jaemin0319/HYPER/mujoco/images/standing_front.png

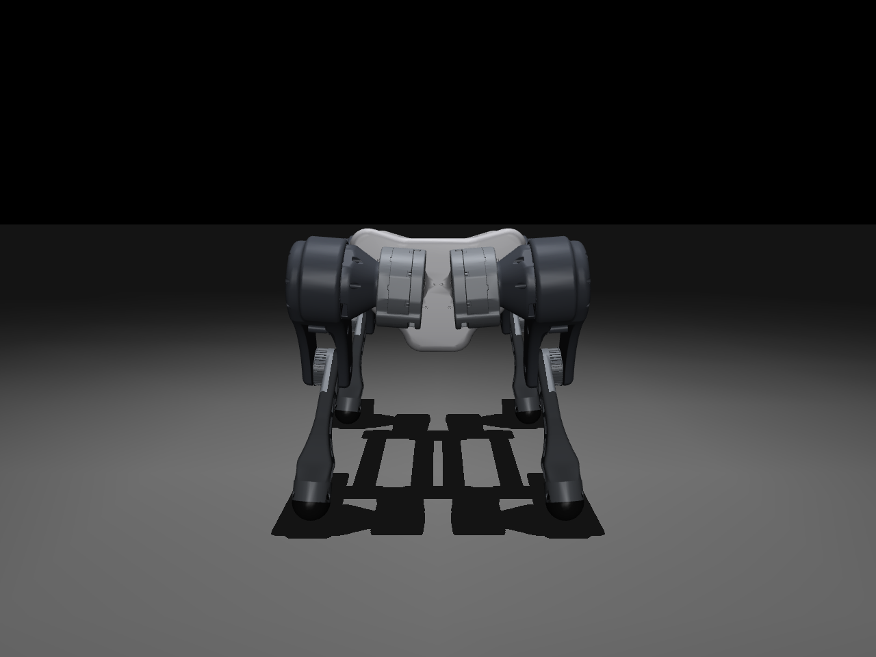
mujoco/images/standing_front.png
