jaemin0319/HYPER/mujoco/images/standing_side.png

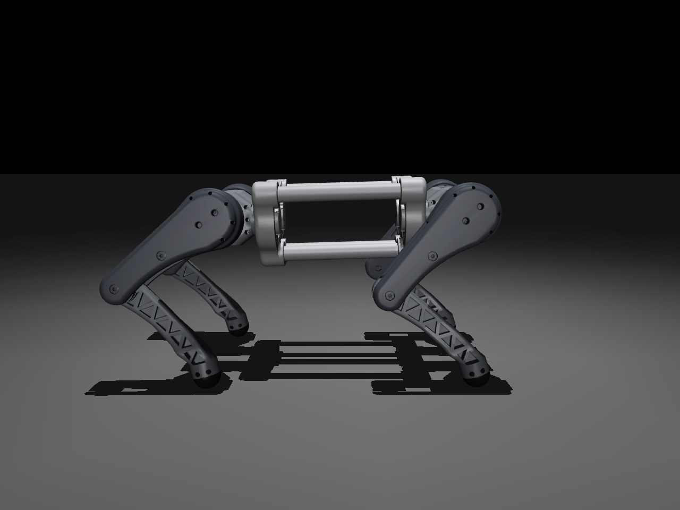
mujoco/images/standing_side.png
