jaemin0319/HYPER/mujoco/images/standing_top.png

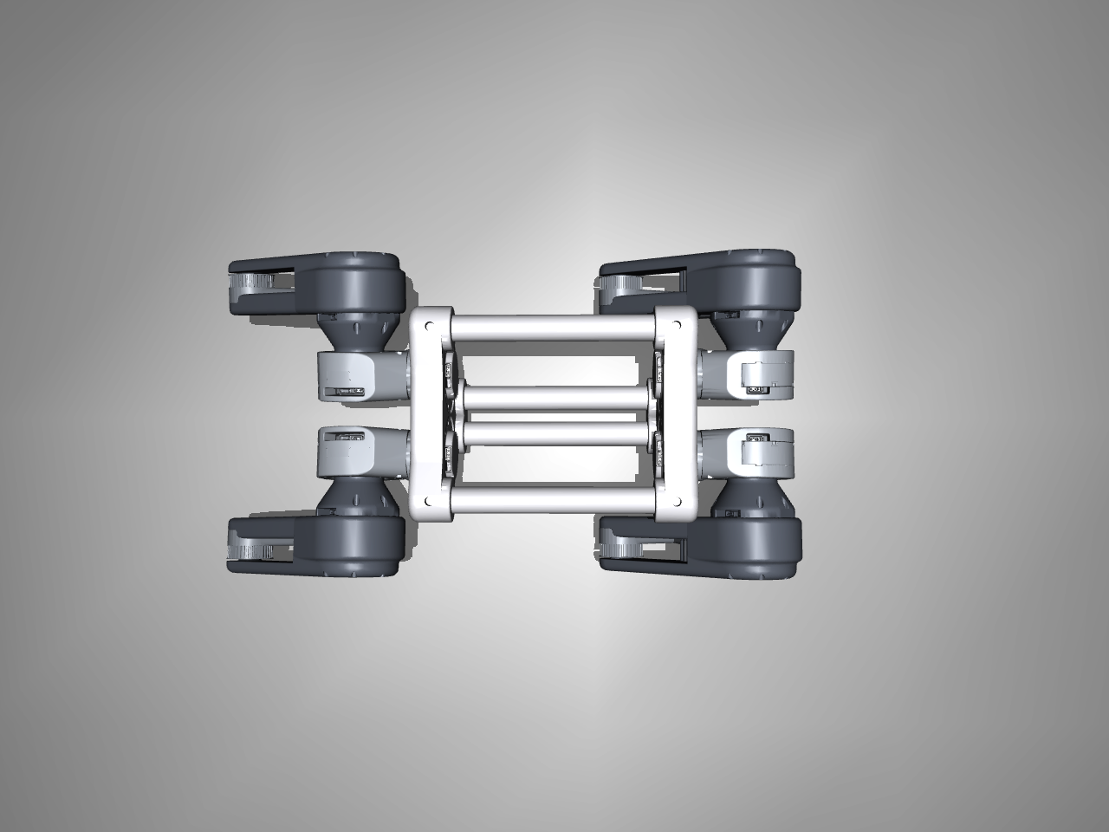
mujoco/images/standing_top.png
