jaemin0319/HYPER/meshes/calf_foot_mirror.stl

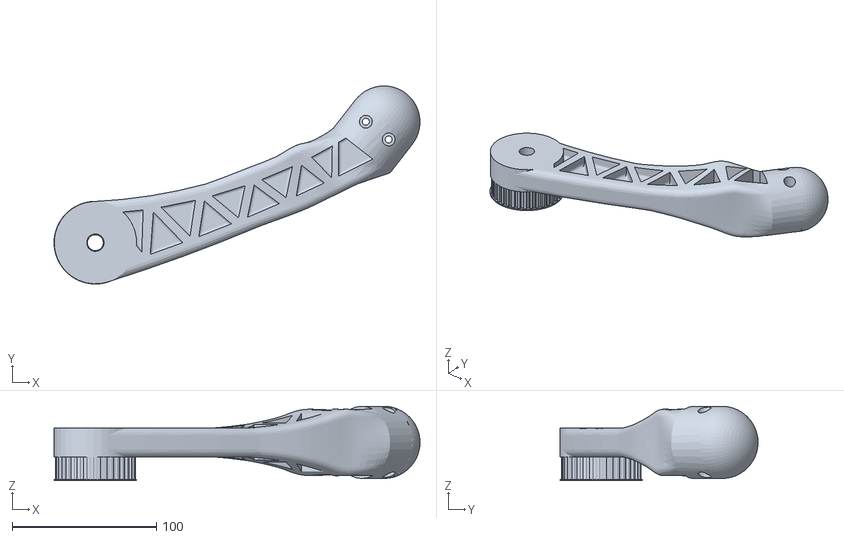
[picture p6: CAD file, 2026-11-10]
meshes/calf_foot_mirror.stl
253.3 x 137.1 x 51.5
