jaemin0319/HYPER/meshes/collision/trunk_c09.stl

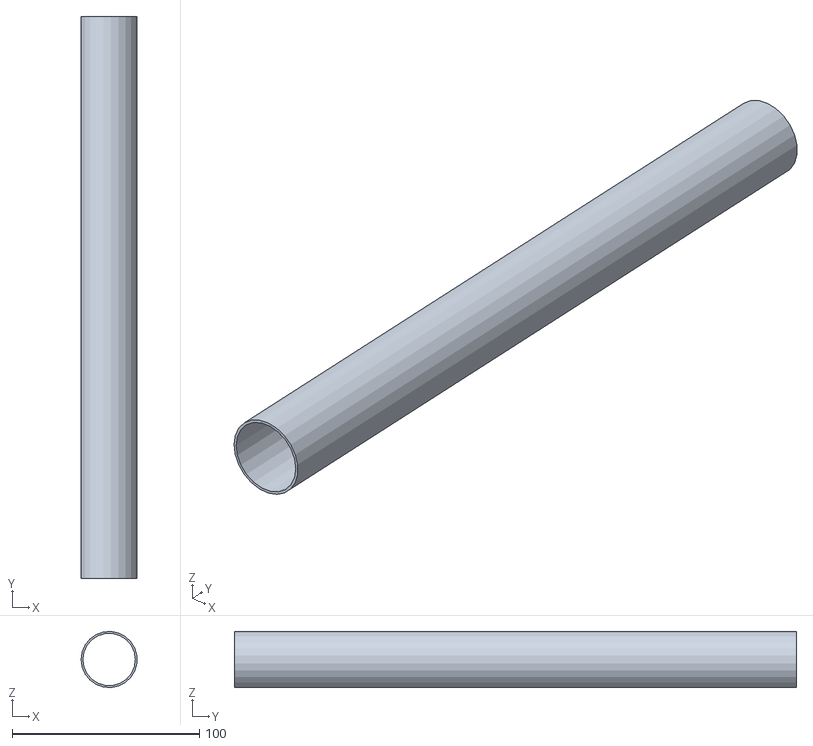
[picture p7: CAD file, 2026-11-10]
meshes/collision/trunk_c09.stl
29.9 x 300.0 x 29.9
