jaemin0319/HYPER/meshes/collision/thigh_c05.stl

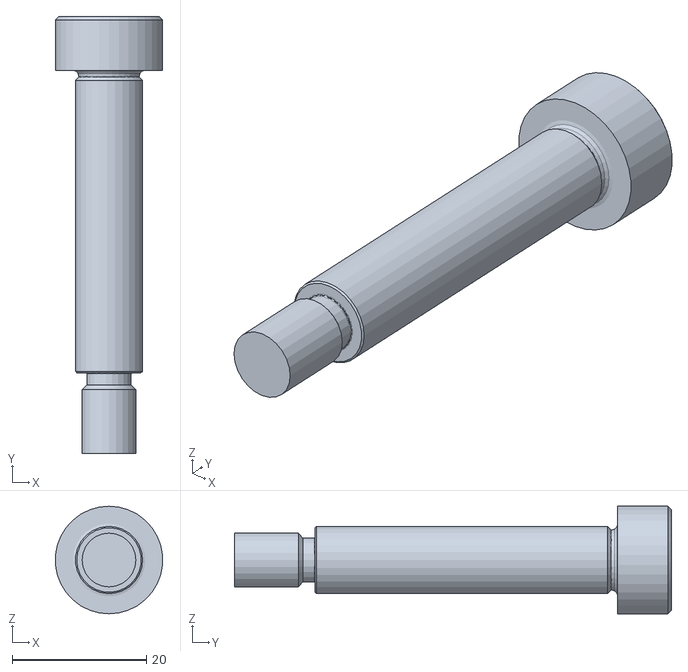
[picture p8: CAD file, 2026-11-10]
meshes/collision/thigh_c05.stl
15.9 x 65.0 x 16.0
