jaemin0319/HYPER/meshes/collision/thigh_c01.stl

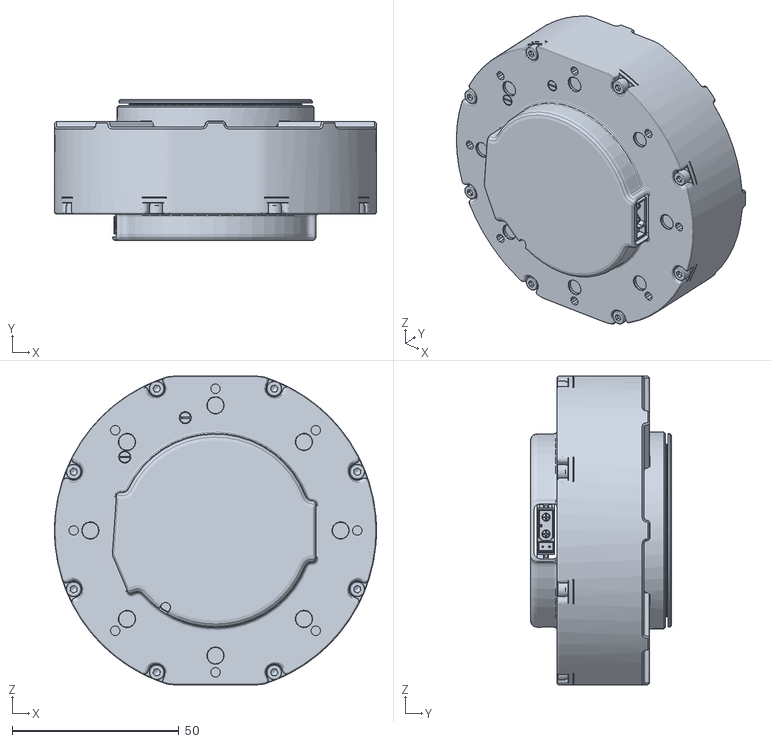
[picture p9: CAD file, 2026-11-10]
meshes/collision/thigh_c01.stl
96.5 x 42.3 x 92.5
