jaemin0319/HYPER/meshes/trunk.stl

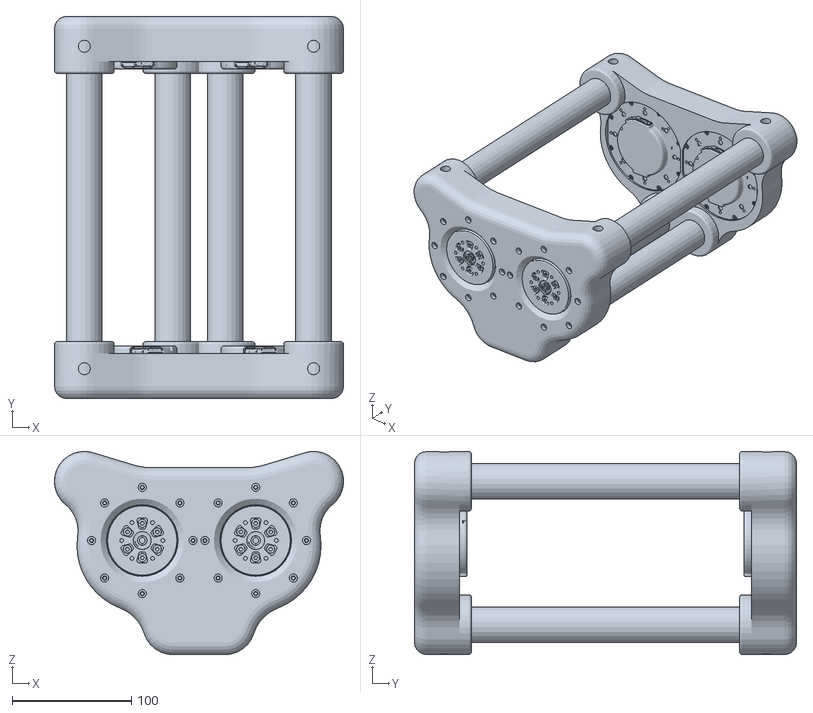
[picture p10: CAD file, 2026-11-10]
meshes/trunk.stl
242.0 x 320.0 x 170.0
