jaemin0319/HYPER/meshes/hip.stl

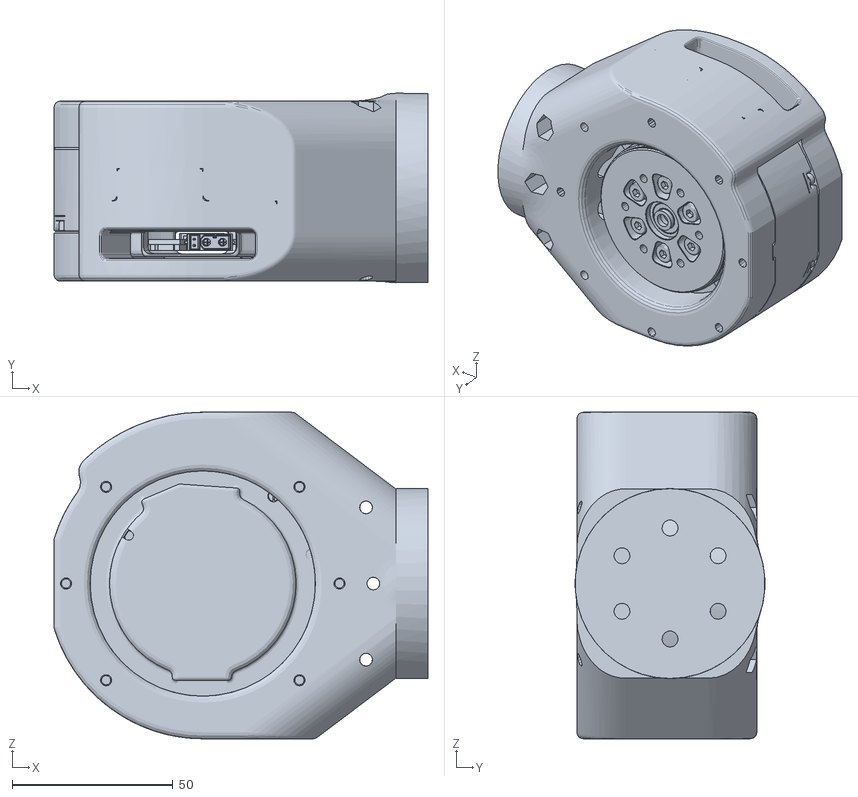
[picture p11: CAD file, 2026-11-10]
meshes/hip.stl
116.3 x 58.9 x 101.5
