jaemin0319/HYPER/meshes/collision/hip_c02_mirror.stl

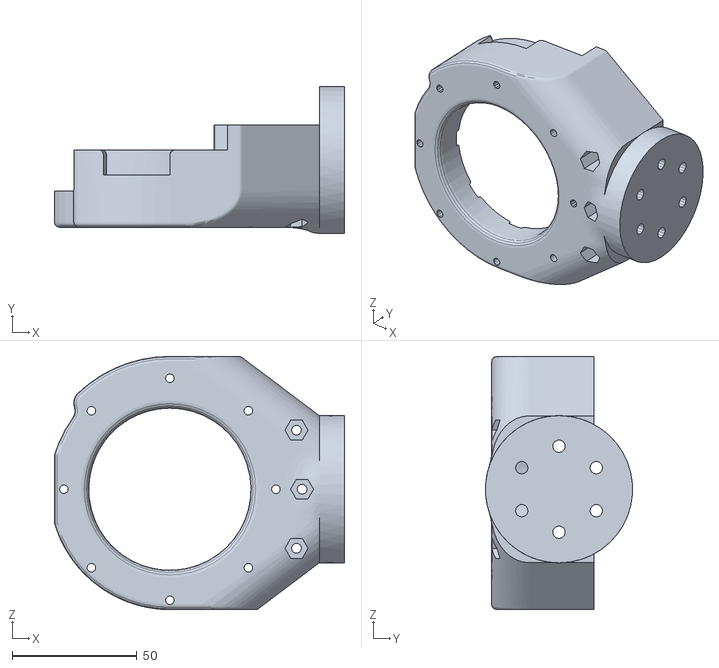
[picture p12: CAD file, 2026-11-10]
meshes/collision/hip_c02_mirror.stl
116.2 x 58.9 x 101.5
