jaemin0319/HYPER/meshes/thigh_mirror.stl

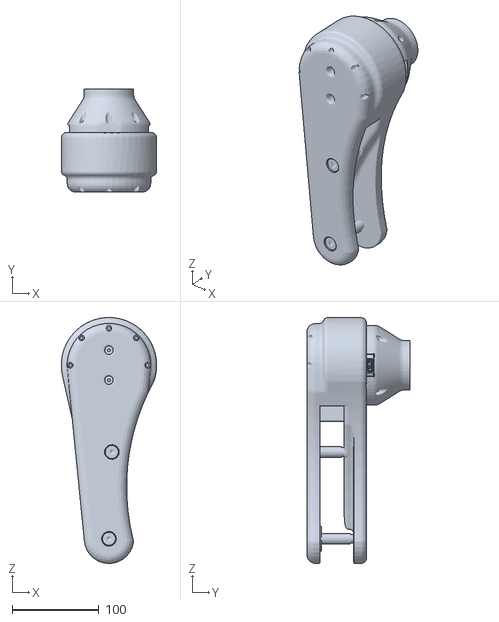
[picture p13: CAD file, 2026-11-10]
meshes/thigh_mirror.stl
109.8 x 119.0 x 283.5
