jaemin0319/HYPER/meshes/collision/thigh_c03_mirror.stl

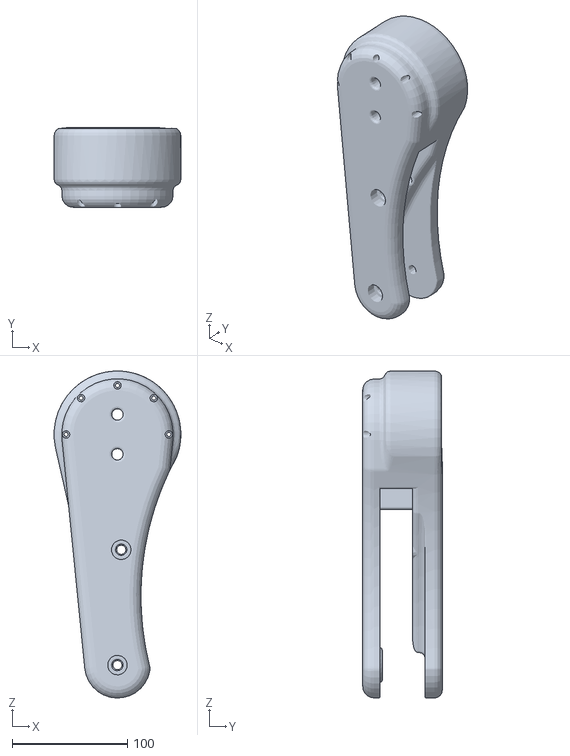
[picture p14: CAD file, 2026-11-10]
meshes/collision/thigh_c03_mirror.stl
109.8 x 69.0 x 283.5
