jaemin0319/HYPER/meshes/collision/trunk_c06.stl

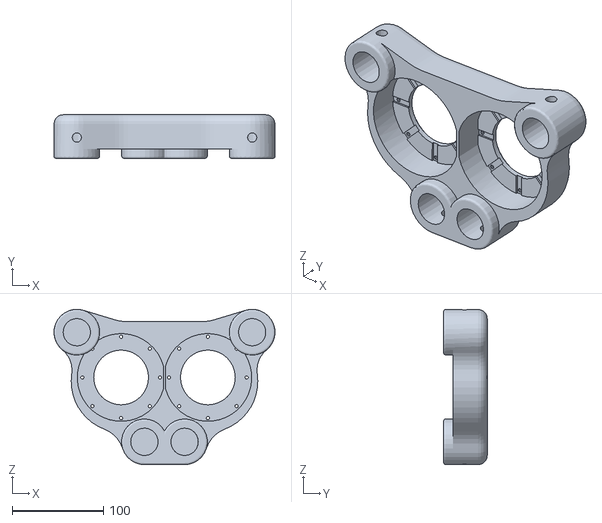
[picture p15: CAD file, 2026-11-10]
meshes/collision/trunk_c06.stl
242.0 x 47.7 x 170.0
