jaemin0319/HYPER/meshes/collision/hip_c03_mirror.stl

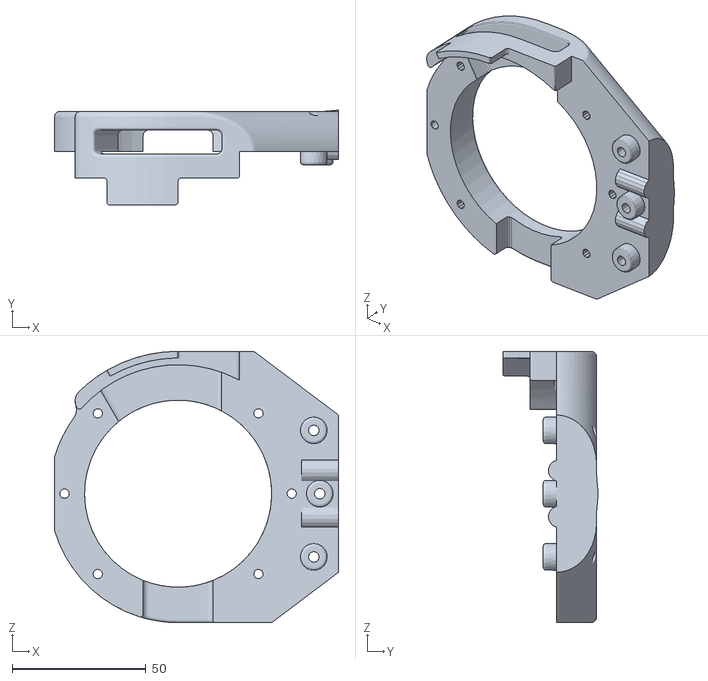
[picture p16: CAD file, 2026-11-10]
meshes/collision/hip_c03_mirror.stl
106.2 x 35.5 x 101.5
