jaemin0319/HYPER/meshes/collision/thigh_c07.stl

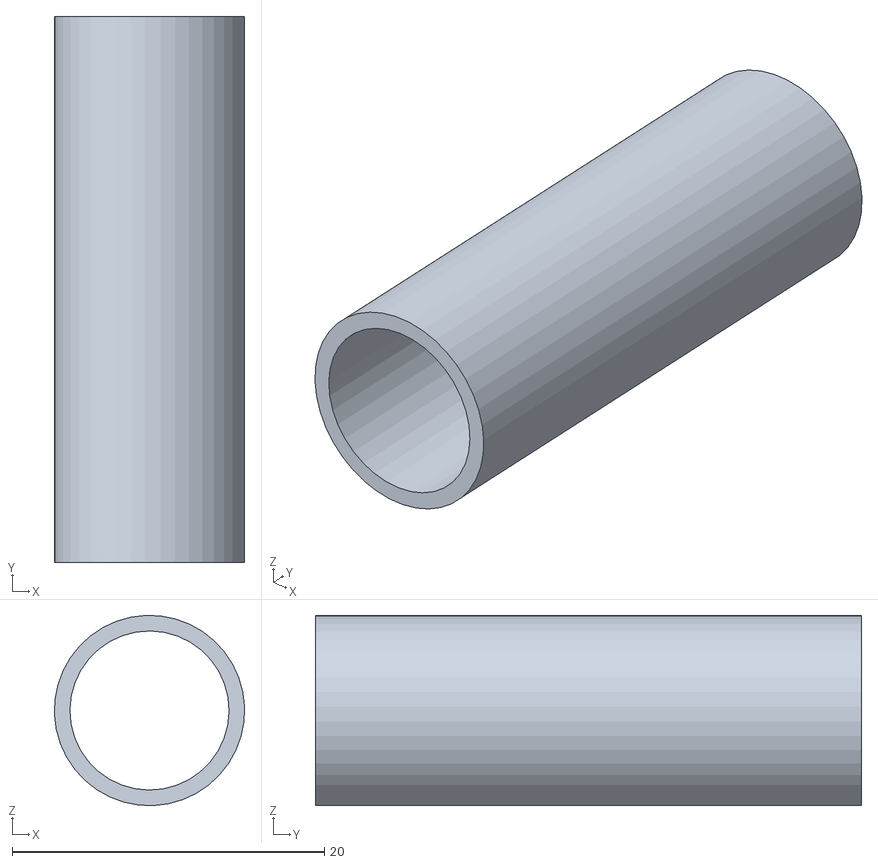
[picture p17: CAD file, 2026-11-10]
meshes/collision/thigh_c07.stl
12.2 x 35.0 x 12.2
