jaemin0319/HYPER/meshes/collision/calf_foot_c03_mirror.stl

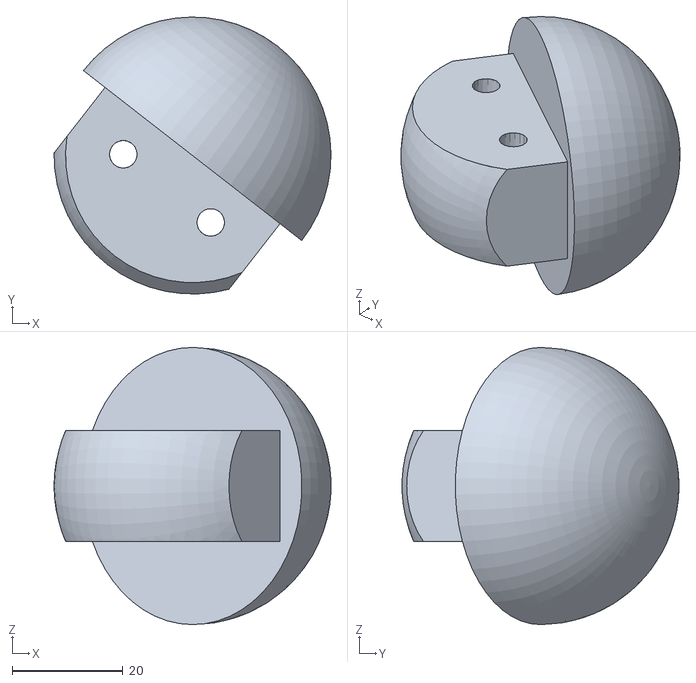
[picture p18: CAD file, 2026-11-10]
meshes/collision/calf_foot_c03_mirror.stl
50.0 x 49.9 x 50.0
