jaemin0319/HYPER/meshes/collision/calf_foot_c02_mirror.stl

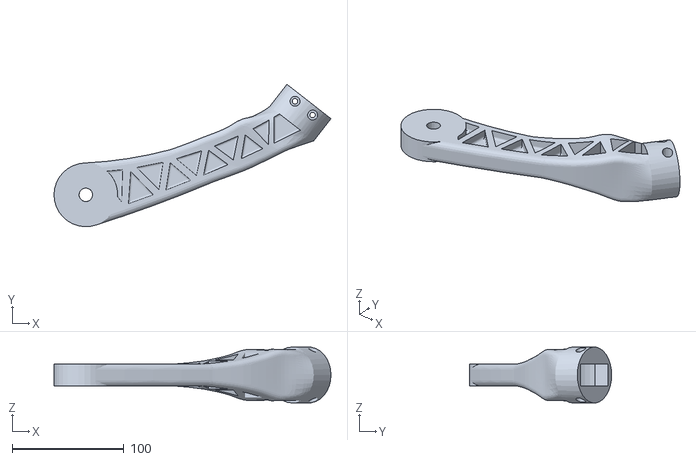
[picture p19: CAD file, 2026-11-10]
meshes/collision/calf_foot_c02_mirror.stl
247.9 x 127.4 x 50.0
