jaemin0319/HYPER/meshes/collision/calf_foot_c01.stl

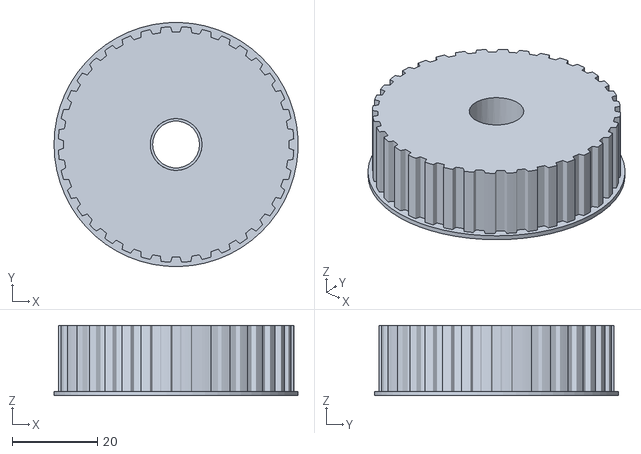
[picture p20: CAD file, 2026-11-10]
meshes/collision/calf_foot_c01.stl
57.3 x 57.3 x 16.5
