jaemin0319/HYPER/meshes/collision/thigh_c02_mirror.stl

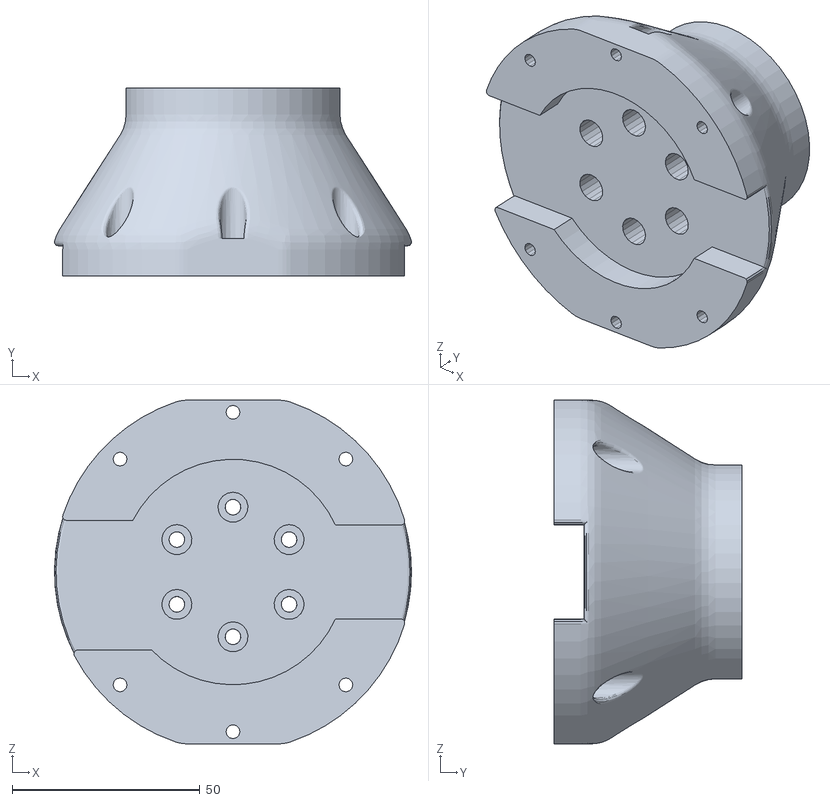
[picture p21: CAD file, 2026-11-10]
meshes/collision/thigh_c02_mirror.stl
95.0 x 50.0 x 91.5
