jaemin0319/HYPER/meshes/collision/thigh_c06_mirror.stl

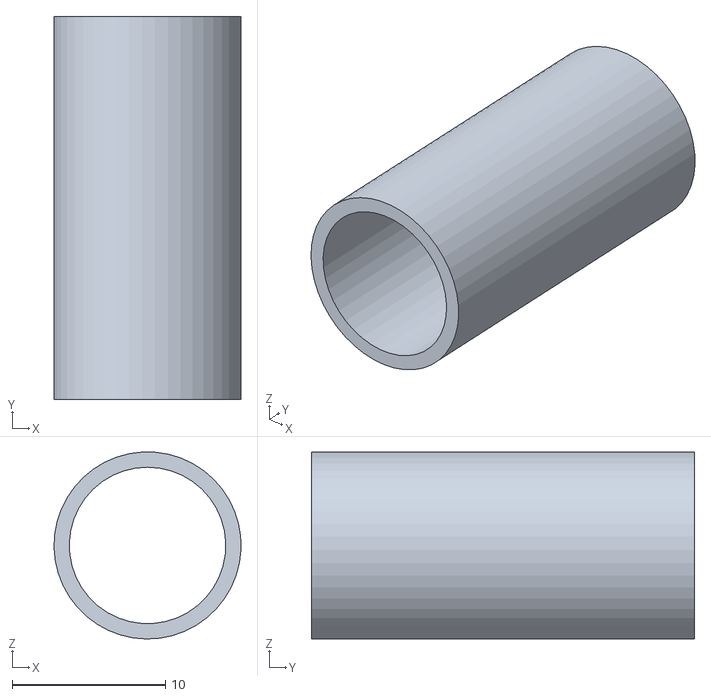
[picture p22: CAD file, 2026-11-10]
meshes/collision/thigh_c06_mirror.stl
12.2 x 25.0 x 12.2
