jaemin0319/HYPER/(list of files, cad)

Other CAD files:
meshes/calf_foot.stl
meshes/collision/trunk_c01.stl
meshes/hip_mirror.stl
meshes/collision/trunk_c08.stl
meshes/collision/thigh_c04_mirror.stl
meshes/thigh.stl
meshes/collision/thigh_c07_mirror.stl
meshes/collision/hip_c03.stl
meshes/collision/trunk_c02.stl
meshes/collision/trunk_c05.stl
meshes/collision/calf_foot_c03.stl
meshes/collision/trunk_c03.stl
meshes/collision/trunk_c07.stl
meshes/collision/thigh_c06.stl
meshes/collision/thigh_c03.stl
meshes/collision/hip_c01.stl
meshes/collision/calf_foot_c02.stl
meshes/collision/hip_c02.stl
meshes/collision/thigh_c04.stl
meshes/collision/thigh_c05_mirror.stl
meshes/collision/trunk_c10.stl
meshes/collision/thigh_c01_mirror.stl
meshes/collision/thigh_c02.stl
meshes/collision/calf_foot_c01_mirror.stl
meshes/collision/hip_c01_mirror.stl
meshes/collision/trunk_c04.stl
