jaemin0319/HYPER/urdf/hyper.urdf

<?xml version="1.0" encoding="utf-8"?>
<!-- hyper_v1 generated by inventor_automation/src/robot_export.py, run 20261110_132904. -->
<!-- Mass, centre of mass, inertia and joint positions: CAD trunk-hip-thigh-calf-foot.iam (Inventor). -->
<!-- Frame convention, joint names and position limits: Unitree Go2, -->
<!--   https://huggingface.co/datasets/unitreerobotics/unitree_model Go2/usd/configuration/go2_description_physics.usd, -->
<!--   as spawned by https://github.com/unitreerobotics/unitree_rl_lab @ 4960b84. -->
<!-- Effort and velocity: Unitree GO-M8010-6 at the output (23.7 N*m, 30 rad/s, gear 6.33) on every joint;
     the calf joint is belt driven 1:1 by a GO-M8010-6 mounted on the thigh. -->
<!-- Right legs mirror the left legs of the CAD about the base x-z plane. -->
<!-- CAD documents with unsaved changes at export (values are their in-memory state): thigh.iam, 숄더M8-L45.ipt -->
<robot name="hyper_v1">
  <!-- Read only by MuJoCo: keep mesh paths relative to this file, collide with the per-part meshes,
       keep the foot links (as Go2's dont_collapse). -->
  <mujoco>
    <compiler strippath="false" discardvisual="true" fusestatic="false"/>
  </mujoco>
  <material name="body"><color rgba="0.75 0.75 0.78 1"/></material>
  <material name="leg"><color rgba="0.25 0.25 0.28 1"/></material>
  <material name="foot"><color rgba="0.1 0.1 0.1 1"/></material>
  <link name="base">
    <inertial>
      <origin xyz="0 0 -0.000639621043705" rpy="0 0 0"/>
      <mass value="2.3042699539"/>
      <inertia ixx="0.00858349317117" ixy="-2.5093192408e-05" ixz="0" iyy="0.0451878348476" iyz="0" izz="0.0501336624466"/>
    </inertial>
    <visual>
      <origin xyz="-0.1260851649 0.0226682414116 -0.0104685283639" rpy="0 0 1.57079632679"/>
      <geometry><mesh filename="../meshes/trunk.stl" scale="0.001 0.001 0.001"/></geometry>
      <material name="body"/>
    </visual>
    <collision name="base_trunk_c01">
      <origin xyz="-0.1260851649 0.0226682414116 -0.0104685283639" rpy="0 0 1.57079632679"/>
      <geometry><mesh filename="../meshes/collision/trunk_c01.stl" scale="0.001 0.001 0.001"/></geometry>
    </collision>
    <collision name="base_trunk_c02">
      <origin xyz="-0.1260851649 0.0226682414116 -0.0104685283639" rpy="0 0 1.57079632679"/>
      <geometry><mesh filename="../meshes/collision/trunk_c02.stl" scale="0.001 0.001 0.001"/></geometry>
    </collision>
    <collision name="base_trunk_c03">
      <origin xyz="-0.1260851649 0.0226682414116 -0.0104685283639" rpy="0 0 1.57079632679"/>
      <geometry><mesh filename="../meshes/collision/trunk_c03.stl" scale="0.001 0.001 0.001"/></geometry>
    </collision>
    <collision name="base_trunk_c04">
      <origin xyz="-0.1260851649 0.0226682414116 -0.0104685283639" rpy="0 0 1.57079632679"/>
      <geometry><mesh filename="../meshes/collision/trunk_c04.stl" scale="0.001 0.001 0.001"/></geometry>
    </collision>
    <collision name="base_trunk_c05">
      <origin xyz="-0.1260851649 0.0226682414116 -0.0104685283639" rpy="0 0 1.57079632679"/>
      <geometry><mesh filename="../meshes/collision/trunk_c05.stl" scale="0.001 0.001 0.001"/></geometry>
    </collision>
    <collision name="base_trunk_c06">
      <origin xyz="-0.1260851649 0.0226682414116 -0.0104685283639" rpy="0 0 1.57079632679"/>
      <geometry><mesh filename="../meshes/collision/trunk_c06.stl" scale="0.001 0.001 0.001"/></geometry>
    </collision>
    <collision name="base_trunk_c07">
      <origin xyz="-0.1260851649 0.0226682414116 -0.0104685283639" rpy="0 0 1.57079632679"/>
      <geometry><mesh filename="../meshes/collision/trunk_c07.stl" scale="0.001 0.001 0.001"/></geometry>
    </collision>
    <collision name="base_trunk_c08">
      <origin xyz="-0.1260851649 0.0226682414116 -0.0104685283639" rpy="0 0 1.57079632679"/>
      <geometry><mesh filename="../meshes/collision/trunk_c08.stl" scale="0.001 0.001 0.001"/></geometry>
    </collision>
    <collision name="base_trunk_c09">
      <origin xyz="-0.1260851649 0.0226682414116 -0.0104685283639" rpy="0 0 1.57079632679"/>
      <geometry><mesh filename="../meshes/collision/trunk_c09.stl" scale="0.001 0.001 0.001"/></geometry>
    </collision>
    <collision name="base_trunk_c10">
      <origin xyz="-0.1260851649 0.0226682414116 -0.0104685283639" rpy="0 0 1.57079632679"/>
      <geometry><mesh filename="../meshes/collision/trunk_c10.stl" scale="0.001 0.001 0.001"/></geometry>
    </collision>
  </link>
  <link name="FL_hip">
    <inertial>
      <origin xyz="-0.00480355465229 0.0010624534626 -0.00071733906153" rpy="0 0 0"/>
      <mass value="0.6709044"/>
      <inertia ixx="0.000515811439886" ixy="-8.15128409291e-06" ixz="4.72324019516e-06" iyy="0.000935208201885" iyz="1.29329169829e-06" izz="0.000599549223576"/>
    </inertial>
    <visual>
      <origin xyz="-0.00356927369941 -0.00835504911739 -0.0025" rpy="3.14159265359 0 -3.14159265359"/>
      <geometry><mesh filename="../meshes/hip.stl" scale="0.001 0.001 0.001"/></geometry>
      <material name="leg"/>
    </visual>
    <collision name="FL_hip_hip_c01">
      <origin xyz="-0.00356927369941 -0.00835504911739 -0.0025" rpy="3.14159265359 0 -3.14159265359"/>
      <geometry><mesh filename="../meshes/collision/hip_c01.stl" scale="0.001 0.001 0.001"/></geometry>
    </collision>
    <collision name="FL_hip_hip_c02">
      <origin xyz="-0.00356927369941 -0.00835504911739 -0.0025" rpy="3.14159265359 0 -3.14159265359"/>
      <geometry><mesh filename="../meshes/collision/hip_c02.stl" scale="0.001 0.001 0.001"/></geometry>
    </collision>
    <collision name="FL_hip_hip_c03">
      <origin xyz="-0.00356927369941 -0.00835504911739 -0.0025" rpy="3.14159265359 0 -3.14159265359"/>
      <geometry><mesh filename="../meshes/collision/hip_c03.stl" scale="0.001 0.001 0.001"/></geometry>
    </collision>
  </link>
  <joint name="FL_hip_joint" type="revolute">
    <origin xyz="0.2283 0.0474993098501 0" rpy="0 0 0"/>
    <parent link="base"/>
    <child link="FL_hip"/>
    <axis xyz="1 0 0"/>
    <limit lower="-1.0472" upper="1.0472" effort="23.7" velocity="30"/>
  </joint>
  <link name="FL_thigh">
    <inertial>
      <origin xyz="-0.00158125047799 -0.00579574861774 -0.0281048957583" rpy="0 0 0"/>
      <mass value="1.08001242798"/>
      <inertia ixx="0.00477452447303" ixy="2.04720529166e-05" ixz="-0.000132458624876" iyy="0.00475372416833" iyz="0.000410792134113" izz="0.00127047158246"/>
    </inertial>
    <visual>
      <origin xyz="0.00132824181889 0.0109241010753 -0.08675" rpy="0 0 0"/>
      <geometry><mesh filename="../meshes/thigh.stl" scale="0.001 0.001 0.001"/></geometry>
      <material name="leg"/>
    </visual>
    <collision name="FL_thigh_thigh_c01">
      <origin xyz="0.00132824181889 0.0109241010753 -0.08675" rpy="0 0 0"/>
      <geometry><mesh filename="../meshes/collision/thigh_c01.stl" scale="0.001 0.001 0.001"/></geometry>
    </collision>
    <collision name="FL_thigh_thigh_c02">
      <origin xyz="0.00132824181889 0.0109241010753 -0.08675" rpy="0 0 0"/>
      <geometry><mesh filename="../meshes/collision/thigh_c02.stl" scale="0.001 0.001 0.001"/></geometry>
    </collision>
    <collision name="FL_thigh_thigh_c03">
      <origin xyz="0.00132824181889 0.0109241010753 -0.08675" rpy="0 0 0"/>
      <geometry><mesh filename="../meshes/collision/thigh_c03.stl" scale="0.001 0.001 0.001"/></geometry>
    </collision>
    <collision name="FL_thigh_thigh_c04">
      <origin xyz="0.00132824181889 0.0109241010753 -0.08675" rpy="0 0 0"/>
      <geometry><mesh filename="../meshes/collision/thigh_c04.stl" scale="0.001 0.001 0.001"/></geometry>
    </collision>
    <collision name="FL_thigh_thigh_c05">
      <origin xyz="0.00132824181889 0.0109241010753 -0.08675" rpy="0 0 0"/>
      <geometry><mesh filename="../meshes/collision/thigh_c05.stl" scale="0.001 0.001 0.001"/></geometry>
    </collision>
    <collision name="FL_thigh_thigh_c06">
      <origin xyz="0.00132824181889 0.0109241010753 -0.08675" rpy="0 0 0"/>
      <geometry><mesh filename="../meshes/collision/thigh_c06.stl" scale="0.001 0.001 0.001"/></geometry>
    </collision>
    <collision name="FL_thigh_thigh_c07">
      <origin xyz="0.00132824181889 0.0109241010753 -0.08675" rpy="0 0 0"/>
      <geometry><mesh filename="../meshes/collision/thigh_c07.stl" scale="0.001 0.001 0.001"/></geometry>
    </collision>
  </link>
  <joint name="FL_thigh_joint" type="revolute">
    <origin xyz="0 0.0958 0" rpy="0 0 0"/>
    <parent link="FL_hip"/>
    <child link="FL_thigh"/>
    <axis xyz="0 1 0"/>
    <limit lower="-1.5708" upper="3.4907" effort="23.7" velocity="30"/>
  </joint>
  <link name="FL_calf">
    <inertial>
      <origin xyz="0.00777982157116 0.00257141086462 -0.0900574283776" rpy="0 0 0"/>
      <mass value="0.1685678"/>
      <inertia ixx="0.00105661410892" ixy="3.36981058187e-06" ixz="6.29325300176e-05" iyy="0.00107478548074" iyz="-3.90244165703e-05" izz="5.78260383263e-05"/>
    </inertial>
    <visual>
      <origin xyz="-0.182443097576 0.0502255825035 -0.0158110046881" rpy="1.57079632679 1.17470632804 0"/>
      <geometry><mesh filename="../meshes/calf_foot.stl" scale="0.001 0.001 0.001"/></geometry>
      <material name="leg"/>
    </visual>
    <collision name="FL_calf_calf_foot_c01">
      <origin xyz="-0.182443097576 0.0502255825035 -0.0158110046881" rpy="1.57079632679 1.17470632804 0"/>
      <geometry><mesh filename="../meshes/collision/calf_foot_c01.stl" scale="0.001 0.001 0.001"/></geometry>
    </collision>
    <collision name="FL_calf_calf_foot_c02">
      <origin xyz="-0.182443097576 0.0502255825035 -0.0158110046881" rpy="1.57079632679 1.17470632804 0"/>
      <geometry><mesh filename="../meshes/collision/calf_foot_c02.stl" scale="0.001 0.001 0.001"/></geometry>
    </collision>
  </link>
  <joint name="FL_calf_joint" type="revolute">
    <origin xyz="0 0 -0.2" rpy="0 0 0"/>
    <parent link="FL_thigh"/>
    <child link="FL_calf"/>
    <axis xyz="0 1 0"/>
    <limit lower="-2.7227" upper="-0.83776" effort="23.7" velocity="30"/>
  </joint>
  <link name="FL_foot">
    <inertial>
      <origin xyz="-0.00129853301443 -2.47778186857e-12 -0.00230529722133" rpy="0 0 0"/>
      <mass value="0.5866"/>
      <inertia ixx="0.000130870315824" ixy="-7.73373418499e-12" ixz="-2.08441365223e-06" iyy="0.000148538549954" iyz="4.38154211265e-12" izz="0.000128343950886"/>
    </inertial>
    <collision>
      <origin xyz="0 0 0" rpy="0 0 0"/>
      <geometry><sphere radius="0.025"/></geometry>
    </collision>
  </link>
  <joint name="FL_foot_joint" type="fixed" dont_collapse="true">
    <origin xyz="0 0 -0.21646923884" rpy="0 0 0"/>
    <parent link="FL_calf"/>
    <child link="FL_foot"/>
  </joint>
  <link name="FR_hip">
    <inertial>
      <origin xyz="-0.00480355465229 -0.0010624534626 -0.00071733906153" rpy="0 0 0"/>
      <mass value="0.6709044"/>
      <inertia ixx="0.000515811439886" ixy="8.15128409291e-06" ixz="4.72324019516e-06" iyy="0.000935208201885" iyz="-1.29329169829e-06" izz="0.000599549223576"/>
    </inertial>
    <visual>
      <origin xyz="-0.00356927369941 0.00835504911739 -0.0025" rpy="-3.14159265359 0 3.14159265359"/>
      <geometry><mesh filename="../meshes/hip_mirror.stl" scale="0.001 0.001 0.001"/></geometry>
      <material name="leg"/>
    </visual>
    <collision name="FR_hip_hip_c01">
      <origin xyz="-0.00356927369941 0.00835504911739 -0.0025" rpy="-3.14159265359 0 3.14159265359"/>
      <geometry><mesh filename="../meshes/collision/hip_c01_mirror.stl" scale="0.001 0.001 0.001"/></geometry>
    </collision>
    <collision name="FR_hip_hip_c02">
      <origin xyz="-0.00356927369941 0.00835504911739 -0.0025" rpy="-3.14159265359 0 3.14159265359"/>
      <geometry><mesh filename="../meshes/collision/hip_c02_mirror.stl" scale="0.001 0.001 0.001"/></geometry>
    </collision>
    <collision name="FR_hip_hip_c03">
      <origin xyz="-0.00356927369941 0.00835504911739 -0.0025" rpy="-3.14159265359 0 3.14159265359"/>
      <geometry><mesh filename="../meshes/collision/hip_c03_mirror.stl" scale="0.001 0.001 0.001"/></geometry>
    </collision>
  </link>
  <joint name="FR_hip_joint" type="revolute">
    <origin xyz="0.2283 -0.0474993098501 0" rpy="0 0 0"/>
    <parent link="base"/>
    <child link="FR_hip"/>
    <axis xyz="1 0 0"/>
    <limit lower="-1.0472" upper="1.0472" effort="23.7" velocity="30"/>
  </joint>
  <link name="FR_thigh">
    <inertial>
      <origin xyz="-0.00158125047799 0.00579574861774 -0.0281048957583" rpy="0 0 0"/>
      <mass value="1.08001242798"/>
      <inertia ixx="0.00477452447303" ixy="-2.04720529166e-05" ixz="-0.000132458624876" iyy="0.00475372416833" iyz="-0.000410792134113" izz="0.00127047158246"/>
    </inertial>
    <visual>
      <origin xyz="0.00132824181889 -0.0109241010753 -0.08675" rpy="0 0 0"/>
      <geometry><mesh filename="../meshes/thigh_mirror.stl" scale="0.001 0.001 0.001"/></geometry>
      <material name="leg"/>
    </visual>
    <collision name="FR_thigh_thigh_c01">
      <origin xyz="0.00132824181889 -0.0109241010753 -0.08675" rpy="0 0 0"/>
      <geometry><mesh filename="../meshes/collision/thigh_c01_mirror.stl" scale="0.001 0.001 0.001"/></geometry>
    </collision>
    <collision name="FR_thigh_thigh_c02">
      <origin xyz="0.00132824181889 -0.0109241010753 -0.08675" rpy="0 0 0"/>
      <geometry><mesh filename="../meshes/collision/thigh_c02_mirror.stl" scale="0.001 0.001 0.001"/></geometry>
    </collision>
    <collision name="FR_thigh_thigh_c03">
      <origin xyz="0.00132824181889 -0.0109241010753 -0.08675" rpy="0 0 0"/>
      <geometry><mesh filename="../meshes/collision/thigh_c03_mirror.stl" scale="0.001 0.001 0.001"/></geometry>
    </collision>
    <collision name="FR_thigh_thigh_c04">
      <origin xyz="0.00132824181889 -0.0109241010753 -0.08675" rpy="0 0 0"/>
      <geometry><mesh filename="../meshes/collision/thigh_c04_mirror.stl" scale="0.001 0.001 0.001"/></geometry>
    </collision>
    <collision name="FR_thigh_thigh_c05">
      <origin xyz="0.00132824181889 -0.0109241010753 -0.08675" rpy="0 0 0"/>
      <geometry><mesh filename="../meshes/collision/thigh_c05_mirror.stl" scale="0.001 0.001 0.001"/></geometry>
    </collision>
    <collision name="FR_thigh_thigh_c06">
      <origin xyz="0.00132824181889 -0.0109241010753 -0.08675" rpy="0 0 0"/>
      <geometry><mesh filename="../meshes/collision/thigh_c06_mirror.stl" scale="0.001 0.001 0.001"/></geometry>
    </collision>
    <collision name="FR_thigh_thigh_c07">
      <origin xyz="0.00132824181889 -0.0109241010753 -0.08675" rpy="0 0 0"/>
      <geometry><mesh filename="../meshes/collision/thigh_c07_mirror.stl" scale="0.001 0.001 0.001"/></geometry>
    </collision>
  </link>
  <joint name="FR_thigh_joint" type="revolute">
    <origin xyz="0 -0.0958 0" rpy="0 0 0"/>
    <parent link="FR_hip"/>
    <child link="FR_thigh"/>
    <axis xyz="0 1 0"/>
    <limit lower="-1.5708" upper="3.4907" effort="23.7" velocity="30"/>
  </joint>
  <link name="FR_calf">
    <inertial>
      <origin xyz="0.00777982157116 -0.00257141086462 -0.0900574283776" rpy="0 0 0"/>
      <mass value="0.1685678"/>
      <inertia ixx="0.00105661410892" ixy="-3.36981058187e-06" ixz="6.29325300176e-05" iyy="0.00107478548074" iyz="3.90244165703e-05" izz="5.78260383263e-05"/>
    </inertial>
    <visual>
      <origin xyz="-0.182443097576 -0.0502255825035 -0.0158110046881" rpy="-1.57079632679 1.17470632804 0"/>
      <geometry><mesh filename="../meshes/calf_foot_mirror.stl" scale="0.001 0.001 0.001"/></geometry>
      <material name="leg"/>
    </visual>
    <collision name="FR_calf_calf_foot_c01">
      <origin xyz="-0.182443097576 -0.0502255825035 -0.0158110046881" rpy="-1.57079632679 1.17470632804 0"/>
      <geometry><mesh filename="../meshes/collision/calf_foot_c01_mirror.stl" scale="0.001 0.001 0.001"/></geometry>
    </collision>
    <collision name="FR_calf_calf_foot_c02">
      <origin xyz="-0.182443097576 -0.0502255825035 -0.0158110046881" rpy="-1.57079632679 1.17470632804 0"/>
      <geometry><mesh filename="../meshes/collision/calf_foot_c02_mirror.stl" scale="0.001 0.001 0.001"/></geometry>
    </collision>
  </link>
  <joint name="FR_calf_joint" type="revolute">
    <origin xyz="0 0 -0.2" rpy="0 0 0"/>
    <parent link="FR_thigh"/>
    <child link="FR_calf"/>
    <axis xyz="0 1 0"/>
    <limit lower="-2.7227" upper="-0.83776" effort="23.7" velocity="30"/>
  </joint>
  <link name="FR_foot">
    <inertial>
      <origin xyz="-0.00129853301443 2.47778186857e-12 -0.00230529722133" rpy="0 0 0"/>
      <mass value="0.5866"/>
      <inertia ixx="0.000130870315824" ixy="7.73373418499e-12" ixz="-2.08441365223e-06" iyy="0.000148538549954" iyz="-4.38154211265e-12" izz="0.000128343950886"/>
    </inertial>
    <collision>
      <origin xyz="0 0 0" rpy="0 0 0"/>
      <geometry><sphere radius="0.025"/></geometry>
    </collision>
  </link>
  <joint name="FR_foot_joint" type="fixed" dont_collapse="true">
    <origin xyz="0 0 -0.21646923884" rpy="0 0 0"/>
    <parent link="FR_calf"/>
    <child link="FR_foot"/>
  </joint>
  <link name="RL_hip">
    <inertial>
      <origin xyz="0.00480355465229 0.0010624534626 0.000717339061528" rpy="0 0 0"/>
      <mass value="0.6709044"/>
      <inertia ixx="0.000515811439886" ixy="8.15128409291e-06" ixz="4.72324019516e-06" iyy="0.000935208201885" iyz="-1.29329169829e-06" izz="0.000599549223576"/>
    </inertial>
    <visual>
      <origin xyz="0.00356927369941 -0.00835504911739 0.0025" rpy="0 0 0"/>
      <geometry><mesh filename="../meshes/hip.stl" scale="0.001 0.001 0.001"/></geometry>
      <material name="leg"/>
    </visual>
    <collision name="RL_hip_hip_c01">
      <origin xyz="0.00356927369941 -0.00835504911739 0.0025" rpy="0 0 0"/>
      <geometry><mesh filename="../meshes/collision/hip_c01.stl" scale="0.001 0.001 0.001"/></geometry>
    </collision>
    <collision name="RL_hip_hip_c02">
      <origin xyz="0.00356927369941 -0.00835504911739 0.0025" rpy="0 0 0"/>
      <geometry><mesh filename="../meshes/collision/hip_c02.stl" scale="0.001 0.001 0.001"/></geometry>
    </collision>
    <collision name="RL_hip_hip_c03">
      <origin xyz="0.00356927369941 -0.00835504911739 0.0025" rpy="0 0 0"/>
      <geometry><mesh filename="../meshes/collision/hip_c03.stl" scale="0.001 0.001 0.001"/></geometry>
    </collision>
  </link>
  <joint name="RL_hip_joint" type="revolute">
    <origin xyz="-0.2283 0.0474993098502 0" rpy="0 0 0"/>
    <parent link="base"/>
    <child link="RL_hip"/>
    <axis xyz="1 0 0"/>
    <limit lower="-1.0472" upper="1.0472" effort="23.7" velocity="30"/>
  </joint>
  <link name="RL_thigh">
    <inertial>
      <origin xyz="-0.00158125047799 -0.00579574861774 -0.0281048957583" rpy="0 0 0"/>
      <mass value="1.08001242798"/>
      <inertia ixx="0.00477452447303" ixy="2.04720529166e-05" ixz="-0.000132458624876" iyy="0.00475372416833" iyz="0.000410792134113" izz="0.00127047158246"/>
    </inertial>
    <visual>
      <origin xyz="0.00132824181889 0.0109241010753 -0.08675" rpy="0 0 0"/>
      <geometry><mesh filename="../meshes/thigh.stl" scale="0.001 0.001 0.001"/></geometry>
      <material name="leg"/>
    </visual>
    <collision name="RL_thigh_thigh_c01">
      <origin xyz="0.00132824181889 0.0109241010753 -0.08675" rpy="0 0 0"/>
      <geometry><mesh filename="../meshes/collision/thigh_c01.stl" scale="0.001 0.001 0.001"/></geometry>
    </collision>
    <collision name="RL_thigh_thigh_c02">
      <origin xyz="0.00132824181889 0.0109241010753 -0.08675" rpy="0 0 0"/>
      <geometry><mesh filename="../meshes/collision/thigh_c02.stl" scale="0.001 0.001 0.001"/></geometry>
    </collision>
    <collision name="RL_thigh_thigh_c03">
      <origin xyz="0.00132824181889 0.0109241010753 -0.08675" rpy="0 0 0"/>
      <geometry><mesh filename="../meshes/collision/thigh_c03.stl" scale="0.001 0.001 0.001"/></geometry>
    </collision>
    <collision name="RL_thigh_thigh_c04">
      <origin xyz="0.00132824181889 0.0109241010753 -0.08675" rpy="0 0 0"/>
      <geometry><mesh filename="../meshes/collision/thigh_c04.stl" scale="0.001 0.001 0.001"/></geometry>
    </collision>
    <collision name="RL_thigh_thigh_c05">
      <origin xyz="0.00132824181889 0.0109241010753 -0.08675" rpy="0 0 0"/>
      <geometry><mesh filename="../meshes/collision/thigh_c05.stl" scale="0.001 0.001 0.001"/></geometry>
    </collision>
    <collision name="RL_thigh_thigh_c06">
      <origin xyz="0.00132824181889 0.0109241010753 -0.08675" rpy="0 0 0"/>
      <geometry><mesh filename="../meshes/collision/thigh_c06.stl" scale="0.001 0.001 0.001"/></geometry>
    </collision>
    <collision name="RL_thigh_thigh_c07">
      <origin xyz="0.00132824181889 0.0109241010753 -0.08675" rpy="0 0 0"/>
      <geometry><mesh filename="../meshes/collision/thigh_c07.stl" scale="0.001 0.001 0.001"/></geometry>
    </collision>
  </link>
  <joint name="RL_thigh_joint" type="revolute">
    <origin xyz="0 0.0958 0" rpy="0 0 0"/>
    <parent link="RL_hip"/>
    <child link="RL_thigh"/>
    <axis xyz="0 1 0"/>
    <limit lower="-0.5236" upper="4.5379" effort="23.7" velocity="30"/>
  </joint>
  <link name="RL_calf">
    <inertial>
      <origin xyz="0.00777982157116 0.00257141086462 -0.0900574283776" rpy="0 0 0"/>
      <mass value="0.1685678"/>
      <inertia ixx="0.00105661410892" ixy="3.36981058187e-06" ixz="6.29325300176e-05" iyy="0.00107478548074" iyz="-3.90244165703e-05" izz="5.78260383263e-05"/>
    </inertial>
    <visual>
      <origin xyz="-0.182443097576 0.0502255825035 -0.0158110046881" rpy="1.57079632679 1.17470632804 0"/>
      <geometry><mesh filename="../meshes/calf_foot.stl" scale="0.001 0.001 0.001"/></geometry>
      <material name="leg"/>
    </visual>
    <collision name="RL_calf_calf_foot_c01">
      <origin xyz="-0.182443097576 0.0502255825035 -0.0158110046881" rpy="1.57079632679 1.17470632804 0"/>
      <geometry><mesh filename="../meshes/collision/calf_foot_c01.stl" scale="0.001 0.001 0.001"/></geometry>
    </collision>
    <collision name="RL_calf_calf_foot_c02">
      <origin xyz="-0.182443097576 0.0502255825035 -0.0158110046881" rpy="1.57079632679 1.17470632804 0"/>
      <geometry><mesh filename="../meshes/collision/calf_foot_c02.stl" scale="0.001 0.001 0.001"/></geometry>
    </collision>
  </link>
  <joint name="RL_calf_joint" type="revolute">
    <origin xyz="0 0 -0.2" rpy="0 0 0"/>
    <parent link="RL_thigh"/>
    <child link="RL_calf"/>
    <axis xyz="0 1 0"/>
    <limit lower="-2.7227" upper="-0.83776" effort="23.7" velocity="30"/>
  </joint>
  <link name="RL_foot">
    <inertial>
      <origin xyz="-0.00129853301443 -2.47780268525e-12 -0.00230529722133" rpy="0 0 0"/>
      <mass value="0.5866"/>
      <inertia ixx="0.000130870315824" ixy="-7.73373408159e-12" ixz="-2.08441365223e-06" iyy="0.000148538549954" iyz="4.38154192149e-12" izz="0.000128343950886"/>
    </inertial>
    <collision>
      <origin xyz="0 0 0" rpy="0 0 0"/>
      <geometry><sphere radius="0.025"/></geometry>
    </collision>
  </link>
  <joint name="RL_foot_joint" type="fixed" dont_collapse="true">
    <origin xyz="0 0 -0.21646923884" rpy="0 0 0"/>
    <parent link="RL_calf"/>
    <child link="RL_foot"/>
  </joint>
  <link name="RR_hip">
    <inertial>
      <origin xyz="0.00480355465229 -0.0010624534626 0.000717339061528" rpy="0 0 0"/>
      <mass value="0.6709044"/>
      <inertia ixx="0.000515811439886" ixy="-8.15128409291e-06" ixz="4.72324019516e-06" iyy="0.000935208201885" iyz="1.29329169829e-06" izz="0.000599549223576"/>
    </inertial>
    <visual>
      <origin xyz="0.00356927369941 0.00835504911739 0.0025" rpy="0 0 0"/>
      <geometry><mesh filename="../meshes/hip_mirror.stl" scale="0.001 0.001 0.001"/></geometry>
      <material name="leg"/>
    </visual>
    <collision name="RR_hip_hip_c01">
      <origin xyz="0.00356927369941 0.00835504911739 0.0025" rpy="0 0 0"/>
      <geometry><mesh filename="../meshes/collision/hip_c01_mirror.stl" scale="0.001 0.001 0.001"/></geometry>
    </collision>
    <collision name="RR_hip_hip_c02">
      <origin xyz="0.00356927369941 0.00835504911739 0.0025" rpy="0 0 0"/>
      <geometry><mesh filename="../meshes/collision/hip_c02_mirror.stl" scale="0.001 0.001 0.001"/></geometry>
    </collision>
    <collision name="RR_hip_hip_c03">
      <origin xyz="0.00356927369941 0.00835504911739 0.0025" rpy="0 0 0"/>
      <geometry><mesh filename="../meshes/collision/hip_c03_mirror.stl" scale="0.001 0.001 0.001"/></geometry>
    </collision>
  </link>
  <joint name="RR_hip_joint" type="revolute">
    <origin xyz="-0.2283 -0.0474993098502 0" rpy="0 0 0"/>
    <parent link="base"/>
    <child link="RR_hip"/>
    <axis xyz="1 0 0"/>
    <limit lower="-1.0472" upper="1.0472" effort="23.7" velocity="30"/>
  </joint>
  <link name="RR_thigh">
    <inertial>
      <origin xyz="-0.00158125047799 0.00579574861774 -0.0281048957583" rpy="0 0 0"/>
      <mass value="1.08001242798"/>
      <inertia ixx="0.00477452447303" ixy="-2.04720529166e-05" ixz="-0.000132458624876" iyy="0.00475372416833" iyz="-0.000410792134113" izz="0.00127047158246"/>
    </inertial>
    <visual>
      <origin xyz="0.00132824181889 -0.0109241010753 -0.08675" rpy="0 0 0"/>
      <geometry><mesh filename="../meshes/thigh_mirror.stl" scale="0.001 0.001 0.001"/></geometry>
      <material name="leg"/>
    </visual>
    <collision name="RR_thigh_thigh_c01">
      <origin xyz="0.00132824181889 -0.0109241010753 -0.08675" rpy="0 0 0"/>
      <geometry><mesh filename="../meshes/collision/thigh_c01_mirror.stl" scale="0.001 0.001 0.001"/></geometry>
    </collision>
    <collision name="RR_thigh_thigh_c02">
      <origin xyz="0.00132824181889 -0.0109241010753 -0.08675" rpy="0 0 0"/>
      <geometry><mesh filename="../meshes/collision/thigh_c02_mirror.stl" scale="0.001 0.001 0.001"/></geometry>
    </collision>
    <collision name="RR_thigh_thigh_c03">
      <origin xyz="0.00132824181889 -0.0109241010753 -0.08675" rpy="0 0 0"/>
      <geometry><mesh filename="../meshes/collision/thigh_c03_mirror.stl" scale="0.001 0.001 0.001"/></geometry>
    </collision>
    <collision name="RR_thigh_thigh_c04">
      <origin xyz="0.00132824181889 -0.0109241010753 -0.08675" rpy="0 0 0"/>
      <geometry><mesh filename="../meshes/collision/thigh_c04_mirror.stl" scale="0.001 0.001 0.001"/></geometry>
    </collision>
    <collision name="RR_thigh_thigh_c05">
      <origin xyz="0.00132824181889 -0.0109241010753 -0.08675" rpy="0 0 0"/>
      <geometry><mesh filename="../meshes/collision/thigh_c05_mirror.stl" scale="0.001 0.001 0.001"/></geometry>
    </collision>
    <collision name="RR_thigh_thigh_c06">
      <origin xyz="0.00132824181889 -0.0109241010753 -0.08675" rpy="0 0 0"/>
      <geometry><mesh filename="../meshes/collision/thigh_c06_mirror.stl" scale="0.001 0.001 0.001"/></geometry>
    </collision>
    <collision name="RR_thigh_thigh_c07">
      <origin xyz="0.00132824181889 -0.0109241010753 -0.08675" rpy="0 0 0"/>
      <geometry><mesh filename="../meshes/collision/thigh_c07_mirror.stl" scale="0.001 0.001 0.001"/></geometry>
    </collision>
  </link>
  <joint name="RR_thigh_joint" type="revolute">
    <origin xyz="0 -0.0958 0" rpy="0 0 0"/>
    <parent link="RR_hip"/>
    <child link="RR_thigh"/>
    <axis xyz="0 1 0"/>
    <limit lower="-0.5236" upper="4.5379" effort="23.7" velocity="30"/>
  </joint>
  <link name="RR_calf">
    <inertial>
      <origin xyz="0.00777982157116 -0.00257141086462 -0.0900574283776" rpy="0 0 0"/>
      <mass value="0.1685678"/>
      <inertia ixx="0.00105661410892" ixy="-3.36981058187e-06" ixz="6.29325300176e-05" iyy="0.00107478548074" iyz="3.90244165703e-05" izz="5.78260383263e-05"/>
    </inertial>
    <visual>
      <origin xyz="-0.182443097576 -0.0502255825035 -0.0158110046881" rpy="-1.57079632679 1.17470632804 0"/>
      <geometry><mesh filename="../meshes/calf_foot_mirror.stl" scale="0.001 0.001 0.001"/></geometry>
      <material name="leg"/>
    </visual>
    <collision name="RR_calf_calf_foot_c01">
      <origin xyz="-0.182443097576 -0.0502255825035 -0.0158110046881" rpy="-1.57079632679 1.17470632804 0"/>
      <geometry><mesh filename="../meshes/collision/calf_foot_c01_mirror.stl" scale="0.001 0.001 0.001"/></geometry>
    </collision>
    <collision name="RR_calf_calf_foot_c02">
      <origin xyz="-0.182443097576 -0.0502255825035 -0.0158110046881" rpy="-1.57079632679 1.17470632804 0"/>
      <geometry><mesh filename="../meshes/collision/calf_foot_c02_mirror.stl" scale="0.001 0.001 0.001"/></geometry>
    </collision>
  </link>
  <joint name="RR_calf_joint" type="revolute">
    <origin xyz="0 0 -0.2" rpy="0 0 0"/>
    <parent link="RR_thigh"/>
    <child link="RR_calf"/>
    <axis xyz="0 1 0"/>
    <limit lower="-2.7227" upper="-0.83776" effort="23.7" velocity="30"/>
  </joint>
  <link name="RR_foot">
    <inertial>
      <origin xyz="-0.00129853301443 2.47780268525e-12 -0.00230529722133" rpy="0 0 0"/>
      <mass value="0.5866"/>
      <inertia ixx="0.000130870315824" ixy="7.73373408159e-12" ixz="-2.08441365223e-06" iyy="0.000148538549954" iyz="-4.38154192149e-12" izz="0.000128343950886"/>
    </inertial>
    <collision>
      <origin xyz="0 0 0" rpy="0 0 0"/>
      <geometry><sphere radius="0.025"/></geometry>
    </collision>
  </link>
  <joint name="RR_foot_joint" type="fixed" dont_collapse="true">
    <origin xyz="0 0 -0.21646923884" rpy="0 0 0"/>
    <parent link="RR_calf"/>
    <child link="RR_foot"/>
  </joint>
</robot>
