jaemin0319/HYPER/mujoco/hyper_scene.xml

<mujoco model="hyper_v1">
  <compiler angle="radian"/>

  <option impratio="100" cone="elliptic"/>

  <size nkey="2"/>

  <visual>
    <global offwidth="1280" offheight="960"/>
  </visual>

  <asset>
    <mesh name="trunk_c01" content_type="model/stl" file="../meshes/collision/trunk_c01.stl" scale="0.001 0.001 0.001"/>
    <mesh name="trunk_c02" content_type="model/stl" file="../meshes/collision/trunk_c02.stl" scale="0.001 0.001 0.001"/>
    <mesh name="trunk_c03" content_type="model/stl" file="../meshes/collision/trunk_c03.stl" scale="0.001 0.001 0.001"/>
    <mesh name="trunk_c04" content_type="model/stl" file="../meshes/collision/trunk_c04.stl" scale="0.001 0.001 0.001"/>
    <mesh name="trunk_c05" content_type="model/stl" file="../meshes/collision/trunk_c05.stl" scale="0.001 0.001 0.001"/>
    <mesh name="trunk_c06" content_type="model/stl" file="../meshes/collision/trunk_c06.stl" scale="0.001 0.001 0.001"/>
    <mesh name="trunk_c07" content_type="model/stl" file="../meshes/collision/trunk_c07.stl" scale="0.001 0.001 0.001"/>
    <mesh name="trunk_c08" content_type="model/stl" file="../meshes/collision/trunk_c08.stl" scale="0.001 0.001 0.001"/>
    <mesh name="trunk_c09" content_type="model/stl" file="../meshes/collision/trunk_c09.stl" scale="0.001 0.001 0.001"/>
    <mesh name="trunk_c10" content_type="model/stl" file="../meshes/collision/trunk_c10.stl" scale="0.001 0.001 0.001"/>
    <mesh name="hip_c01" content_type="model/stl" file="../meshes/collision/hip_c01.stl" scale="0.001 0.001 0.001"/>
    <mesh name="hip_c02" content_type="model/stl" file="../meshes/collision/hip_c02.stl" scale="0.001 0.001 0.001"/>
    <mesh name="hip_c03" content_type="model/stl" file="../meshes/collision/hip_c03.stl" scale="0.001 0.001 0.001"/>
    <mesh name="thigh_c01" content_type="model/stl" file="../meshes/collision/thigh_c01.stl" scale="0.001 0.001 0.001"/>
    <mesh name="thigh_c02" content_type="model/stl" file="../meshes/collision/thigh_c02.stl" scale="0.001 0.001 0.001"/>
    <mesh name="thigh_c03" content_type="model/stl" file="../meshes/collision/thigh_c03.stl" scale="0.001 0.001 0.001"/>
    <mesh name="thigh_c04" content_type="model/stl" file="../meshes/collision/thigh_c04.stl" scale="0.001 0.001 0.001"/>
    <mesh name="thigh_c05" content_type="model/stl" file="../meshes/collision/thigh_c05.stl" scale="0.001 0.001 0.001"/>
    <mesh name="thigh_c06" content_type="model/stl" file="../meshes/collision/thigh_c06.stl" scale="0.001 0.001 0.001"/>
    <mesh name="thigh_c07" content_type="model/stl" file="../meshes/collision/thigh_c07.stl" scale="0.001 0.001 0.001"/>
    <mesh name="calf_foot_c01" content_type="model/stl" file="../meshes/collision/calf_foot_c01.stl" scale="0.001 0.001 0.001"/>
    <mesh name="calf_foot_c02" content_type="model/stl" file="../meshes/collision/calf_foot_c02.stl" scale="0.001 0.001 0.001"/>
    <mesh name="hip_c01_mirror" content_type="model/stl" file="../meshes/collision/hip_c01_mirror.stl" scale="0.001 0.001 0.001"/>
    <mesh name="hip_c02_mirror" content_type="model/stl" file="../meshes/collision/hip_c02_mirror.stl" scale="0.001 0.001 0.001"/>
    <mesh name="hip_c03_mirror" content_type="model/stl" file="../meshes/collision/hip_c03_mirror.stl" scale="0.001 0.001 0.001"/>
    <mesh name="thigh_c01_mirror" content_type="model/stl" file="../meshes/collision/thigh_c01_mirror.stl" scale="0.001 0.001 0.001"/>
    <mesh name="thigh_c02_mirror" content_type="model/stl" file="../meshes/collision/thigh_c02_mirror.stl" scale="0.001 0.001 0.001"/>
    <mesh name="thigh_c03_mirror" content_type="model/stl" file="../meshes/collision/thigh_c03_mirror.stl" scale="0.001 0.001 0.001"/>
    <mesh name="thigh_c04_mirror" content_type="model/stl" file="../meshes/collision/thigh_c04_mirror.stl" scale="0.001 0.001 0.001"/>
    <mesh name="thigh_c05_mirror" content_type="model/stl" file="../meshes/collision/thigh_c05_mirror.stl" scale="0.001 0.001 0.001"/>
    <mesh name="thigh_c06_mirror" content_type="model/stl" file="../meshes/collision/thigh_c06_mirror.stl" scale="0.001 0.001 0.001"/>
    <mesh name="thigh_c07_mirror" content_type="model/stl" file="../meshes/collision/thigh_c07_mirror.stl" scale="0.001 0.001 0.001"/>
    <mesh name="calf_foot_c01_mirror" content_type="model/stl" file="../meshes/collision/calf_foot_c01_mirror.stl" scale="0.001 0.001 0.001"/>
    <mesh name="calf_foot_c02_mirror" content_type="model/stl" file="../meshes/collision/calf_foot_c02_mirror.stl" scale="0.001 0.001 0.001"/>
  </asset>

  <worldbody>
    <geom name="floor" size="0 0 0.05" type="plane"/>
    <light name="sun" pos="0 0 3" diffuse="0.8 0.8 0.8"/>
    <body name="base">
      <inertial pos="0 0 -0.000639621" quat="-0.00024237 0.707107 0.00024237 0.707107" mass="2.30427" diaginertia="0.0501337 0.0451879 0.00858348"/>
      <joint name="floating_base" type="free"/>
      <geom name="base_trunk_c01" pos="-0.126085 0.0226682 -0.0104685" quat="0.707107 0 0 0.707107" type="mesh" rgba="0.78 0.78 0.8 1" mesh="trunk_c01"/>
      <geom name="base_trunk_c02" pos="-0.126085 0.0226682 -0.0104685" quat="0.707107 0 0 0.707107" type="mesh" rgba="0.78 0.78 0.8 1" mesh="trunk_c02"/>
      <geom name="base_trunk_c03" pos="-0.126085 0.0226682 -0.0104685" quat="0.707107 0 0 0.707107" type="mesh" rgba="0.78 0.78 0.8 1" mesh="trunk_c03"/>
      <geom name="base_trunk_c04" pos="-0.126085 0.0226682 -0.0104685" quat="0.707107 0 0 0.707107" type="mesh" rgba="0.78 0.78 0.8 1" mesh="trunk_c04"/>
      <geom name="base_trunk_c05" pos="-0.126085 0.0226682 -0.0104685" quat="0.707107 0 0 0.707107" type="mesh" rgba="0.78 0.78 0.8 1" mesh="trunk_c05"/>
      <geom name="base_trunk_c06" pos="-0.126085 0.0226682 -0.0104685" quat="0.707107 0 0 0.707107" type="mesh" rgba="0.78 0.78 0.8 1" mesh="trunk_c06"/>
      <geom name="base_trunk_c07" pos="-0.126085 0.0226682 -0.0104685" quat="0.707107 0 0 0.707107" type="mesh" rgba="0.78 0.78 0.8 1" mesh="trunk_c07"/>
      <geom name="base_trunk_c08" pos="-0.126085 0.0226682 -0.0104685" quat="0.707107 0 0 0.707107" type="mesh" rgba="0.78 0.78 0.8 1" mesh="trunk_c08"/>
      <geom name="base_trunk_c09" pos="-0.126085 0.0226682 -0.0104685" quat="0.707107 0 0 0.707107" type="mesh" rgba="0.78 0.78 0.8 1" mesh="trunk_c09"/>
      <geom name="base_trunk_c10" pos="-0.126085 0.0226682 -0.0104685" quat="0.707107 0 0 0.707107" type="mesh" rgba="0.78 0.78 0.8 1" mesh="trunk_c10"/>
      <body name="FL_hip" pos="0.2283 0.0474993 0">
        <inertial pos="-0.00480355 0.00106245 -0.000717339" quat="0.480056 0.509759 0.517983 0.49131" mass="0.670904" diaginertia="0.000935371 0.000599813 0.000515385"/>
        <joint name="FL_hip_joint" range="-1.0472 1.0472" actuatorfrcrange="-23.7 23.7" axis="1 0 0"/>
        <geom name="FL_hip_hip_c01" pos="-0.00356927 -0.00835505 -0.0025" quat="0 0 -1 0" type="mesh" rgba="0.55 0.57 0.6 1" mesh="hip_c01"/>
        <geom name="FL_hip_hip_c02" pos="-0.00356927 -0.00835505 -0.0025" quat="0 0 -1 0" type="mesh" rgba="0.55 0.57 0.6 1" mesh="hip_c02"/>
        <geom name="FL_hip_hip_c03" pos="-0.00356927 -0.00835505 -0.0025" quat="0 0 -1 0" type="mesh" rgba="0.55 0.57 0.6 1" mesh="hip_c03"/>
        <body name="FL_thigh" pos="0 0.0958 0">
          <inertial pos="-0.00158125 -0.00579575 -0.0281049" quat="0.776672 0.0568705 -0.0216834 0.626958" mass="1.08001" diaginertia="0.00480261 0.00477847 0.00121764"/>
          <joint name="FL_thigh_joint" range="-1.5708 3.4907" actuatorfrcrange="-23.7 23.7" axis="0 1 0"/>
          <geom name="FL_thigh_thigh_c01" pos="0.00132824 0.0109241 -0.08675" quat="1 0 0 0" type="mesh" rgba="0.3 0.32 0.36 1" mesh="thigh_c01"/>
          <geom name="FL_thigh_thigh_c02" pos="0.00132824 0.0109241 -0.08675" quat="1 0 0 0" type="mesh" rgba="0.3 0.32 0.36 1" mesh="thigh_c02"/>
          <geom name="FL_thigh_thigh_c03" pos="0.00132824 0.0109241 -0.08675" quat="1 0 0 0" type="mesh" rgba="0.3 0.32 0.36 1" mesh="thigh_c03"/>
          <geom name="FL_thigh_thigh_c04" pos="0.00132824 0.0109241 -0.08675" quat="1 0 0 0" type="mesh" rgba="0.3 0.32 0.36 1" mesh="thigh_c04"/>
          <geom name="FL_thigh_thigh_c05" pos="0.00132824 0.0109241 -0.08675" quat="1 0 0 0" type="mesh" rgba="0.3 0.32 0.36 1" mesh="thigh_c05"/>
          <geom name="FL_thigh_thigh_c06" pos="0.00132824 0.0109241 -0.08675" quat="1 0 0 0" type="mesh" rgba="0.3 0.32 0.36 1" mesh="thigh_c06"/>
          <geom name="FL_thigh_thigh_c07" pos="0.00132824 0.0109241 -0.08675" quat="1 0 0 0" type="mesh" rgba="0.3 0.32 0.36 1" mesh="thigh_c07"/>
          <body name="FL_calf" pos="0 0 -0.2">
            <inertial pos="0.00777982 0.00257141 -0.0900574" quat="0.72728 -0.0354259 -0.00967131 0.685358" mass="0.168568" diaginertia="0.00107634 0.00106051 5.23765e-05"/>
            <joint name="FL_calf_joint" range="-2.7227 -0.83776" actuatorfrcrange="-23.7 23.7" axis="0 1 0"/>
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
            </body>
          </body>
        </body>
      </body>
      <body name="RR_hip" pos="-0.2283 -0.0474993 0">
        <inertial pos="0.00480355 -0.00106245 0.000717339" quat="0.480056 0.509759 0.517983 0.49131" mass="0.670904" diaginertia="0.000935371 0.000599813 0.000515385"/>
        <joint name="RR_hip_joint" range="-1.0472 1.0472" actuatorfrcrange="-23.7 23.7" axis="1 0 0"/>
        <geom name="RR_hip_hip_c01" pos="0.00356927 0.00835505 0.0025" quat="1 0 0 0" type="mesh" rgba="0.55 0.57 0.6 1" mesh="hip_c01_mirror"/>
        <geom name="RR_hip_hip_c02" pos="0.00356927 0.00835505 0.0025" quat="1 0 0 0" type="mesh" rgba="0.55 0.57 0.6 1" mesh="hip_c02_mirror"/>
        <geom name="RR_hip_hip_c03" pos="0.00356927 0.00835505 0.0025" quat="1 0 0 0" type="mesh" rgba="0.55 0.57 0.6 1" mesh="hip_c03_mirror"/>
        <body name="RR_thigh" pos="0 -0.0958 0">
          <inertial pos="-0.00158125 0.00579575 -0.0281049" quat="0.626958 -0.0216834 0.0568705 0.776672" mass="1.08001" diaginertia="0.00480261 0.00477847 0.00121764"/>
          <joint name="RR_thigh_joint" range="-0.5236 4.5379" actuatorfrcrange="-23.7 23.7" axis="0 1 0"/>
          <geom name="RR_thigh_thigh_c01" pos="0.00132824 -0.0109241 -0.08675" quat="1 0 0 0" type="mesh" rgba="0.3 0.32 0.36 1" mesh="thigh_c01_mirror"/>
          <geom name="RR_thigh_thigh_c02" pos="0.00132824 -0.0109241 -0.08675" quat="1 0 0 0" type="mesh" rgba="0.3 0.32 0.36 1" mesh="thigh_c02_mirror"/>
          <geom name="RR_thigh_thigh_c03" pos="0.00132824 -0.0109241 -0.08675" quat="1 0 0 0" type="mesh" rgba="0.3 0.32 0.36 1" mesh="thigh_c03_mirror"/>
          <geom name="RR_thigh_thigh_c04" pos="0.00132824 -0.0109241 -0.08675" quat="1 0 0 0" type="mesh" rgba="0.3 0.32 0.36 1" mesh="thigh_c04_mirror"/>
          <geom name="RR_thigh_thigh_c05" pos="0.00132824 -0.0109241 -0.08675" quat="1 0 0 0" type="mesh" rgba="0.3 0.32 0.36 1" mesh="thigh_c05_mirror"/>
          <geom name="RR_thigh_thigh_c06" pos="0.00132824 -0.0109241 -0.08675" quat="1 0 0 0" type="mesh" rgba="0.3 0.32 0.36 1" mesh="thigh_c06_mirror"/>
          <geom name="RR_thigh_thigh_c07" pos="0.00132824 -0.0109241 -0.08675" quat="1 0 0 0" type="mesh" rgba="0.3 0.32 0.36 1" mesh="thigh_c07_mirror"/>
          <body name="RR_calf" pos="0 0 -0.2">
            <inertial pos="0.00777982 -0.00257141 -0.0900574" quat="0.685358 -0.00967131 -0.0354259 0.72728" mass="0.168568" diaginertia="0.00107634 0.00106051 5.23765e-05"/>
            <joint name="RR_calf_joint" range="-2.7227 -0.83776" actuatorfrcrange="-23.7 23.7" axis="0 1 0"/>
            <geom name="RR_calf_calf_foot_c01" pos="-0.182443 -0.0502256 -0.015811" quat="0.588603 -0.588603 0.39185 0.39185" type="mesh" rgba="0.45 0.47 0.5 1" mesh="calf_foot_c01_mirror"/>
            <geom name="RR_calf_calf_foot_c02" pos="-0.182443 -0.0502256 -0.015811" quat="0.588603 -0.588603 0.39185 0.39185" type="mesh" rgba="0.45 0.47 0.5 1" mesh="calf_foot_c02_mirror"/>
            <body name="RR_foot" pos="0 0 -0.216469">
              <inertial pos="-0.00129853 2.4778e-12 -0.0023053" quat="0.683975 0.179385 0.179385 0.683974" mass="0.5866" diaginertia="0.000148539 0.000132044 0.00012717"/>
              <geom size="0.025" rgba="0.08 0.08 0.08 1"/>
            </body>
          </body>
        </body>
      </body>
    </body>
  </worldbody>

  <actuator>
    <general name="FL_hip_joint" joint="FL_hip_joint" ctrlrange="-23.7 23.7" ctrllimited="true"/>
    <general name="FL_thigh_joint" joint="FL_thigh_joint" ctrlrange="-23.7 23.7" ctrllimited="true"/>
    <general name="FL_calf_joint" joint="FL_calf_joint" ctrlrange="-23.7 23.7" ctrllimited="true"/>
    <general name="FR_hip_joint" joint="FR_hip_joint" ctrlrange="-23.7 23.7" ctrllimited="true"/>
    <general name="FR_thigh_joint" joint="FR_thigh_joint" ctrlrange="-23.7 23.7" ctrllimited="true"/>
    <general name="FR_calf_joint" joint="FR_calf_joint" ctrlrange="-23.7 23.7" ctrllimited="true"/>
    <general name="RL_hip_joint" joint="RL_hip_joint" ctrlrange="-23.7 23.7" ctrllimited="true"/>
    <general name="RL_thigh_joint" joint="RL_thigh_joint" ctrlrange="-23.7 23.7" ctrllimited="true"/>
    <general name="RL_calf_joint" joint="RL_calf_joint" ctrlrange="-23.7 23.7" ctrllimited="true"/>
    <general name="RR_hip_joint" joint="RR_hip_joint" ctrlrange="-23.7 23.7" ctrllimited="true"/>
    <general name="RR_thigh_joint" joint="RR_thigh_joint" ctrlrange="-23.7 23.7" ctrllimited="true"/>
    <general name="RR_calf_joint" joint="RR_calf_joint" ctrlrange="-23.7 23.7" ctrllimited="true"/>
  </actuator>

  <keyframe>
    <key name="init" qpos="0 0 0.4 1 0 0 0 0.1 0.8 -1.5 -0.1 0.8 -1.5 0.1 1 -1.5 -0.1 1 -1.5"/>
    <key name="cad" qpos="0 0 0.282153 1 0 0 0 0 0.944171 -1.91485 0 0.944171 -1.91485 0.0711928 0.820639 -1.76856 -0.0711928 0.820639 -1.76856"/>
  </keyframe>
</mujoco>
