jaemin0319/HYPER/(commit log)

2026-11-10 HYPER v1 quadruped URDF
    Generated from the Inventor assembly trunk-hip-thigh-calf-foot.iam (left legs;
    right legs mirrored). Frame convention, joint names, limits, effort and velocity
    follow Unitree Go2 (unitree_model go2.usd, unitree_rl_lab 4960b84).
    - urdf/hyper.urdf, meshes (visual STL as provided, per-part collision STL)
    - mujoco scene and viewer with the Go2 PD and torque-speed limit
    - isaaclab/hyper_cfg.py adapted from UNITREE_GO2_CFG
    - properties and validation results
    [calf-foot.stl, calf-foot_c01.stl, calf-foot_c01_mirror.stl, calf-foot_c02.stl, calf-foot_c02_mirror.stl, calf-foot_c03.stl, calf-foot_c03_mirror.stl, calf-foot_mirror.stl]
2026-11-10 Add Isaac Sim 5.1 USD, rename calf-foot meshes, GO-M8010-6 joint limits
    - usd/hyper.usd (+ configuration layers) converted from urdf/hyper.urdf with
    the Isaac Sim URDF importer through Isaac Lab's UrdfConverter, and
    usd/hyper_scene.usda (ground, lights, robot at the Isaac Lab init pose).
    hyper_base.usd (80 MB) is stored with Git LFS.
    - isaacsim/: conversion, scene, viewer, snapshot and a 31-item check against
    the URDF and mujoco/check_result.json (mass/inertia, joints, mesh placement,
    materials, PhysX standing, self-contact sweep). All pass.
    - Importer workarounds: '-' in mesh names breaks visual prim paths (meshes
    renamed calf-foot* -> calf_foot*; Inventor names kept), URDF colo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
    [calf_foot.stl, calf_foot_c01.stl, calf_foot_c01_mirror.stl, calf_foot_c02.stl, calf_foot_c02_mirror.stl, calf_foot_c03.stl, calf_foot_c03_mirror.stl, calf_foot_mirror.stl]
2026-11-10 Add Isaac Lab velocity tasks, flat policy and motor-feedback-only deploy code
    - isaaclab/hyper_lab: Isaac-Velocity-{Flat,Rough}-HYPER{,-Play}-v0 inheriting the
    Isaac Lab 2.3 Go2 configs. GO-M8010-6 DCMotor (23.7 N·m, 30 rad/s, kp 25, kd 0.5),
    blind actor obs (command, q, dq, last action) with an asymmetric critic,
    self-collision on, thigh undesired_contacts, base-ground filtered termination.
    - isaaclab/scripts: train/play wrappers, check_env, export_deploy, teleop.
    - deploy: numpy controller (passive/stand/walk/damp), MuJoCo and GO-M8010-6
    (unitree_actuator_sdk) backends, joystick/keyboard input, tests.
    - deploy/policies/flat: 300-iteration flat policy with Isaac and MuJoCo results.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
    [backends.py, commands.py, controller.py]
